jbudworth/LegoNXT_SpektrumSatRx/LegoNXT_Spektrum_wiring.png

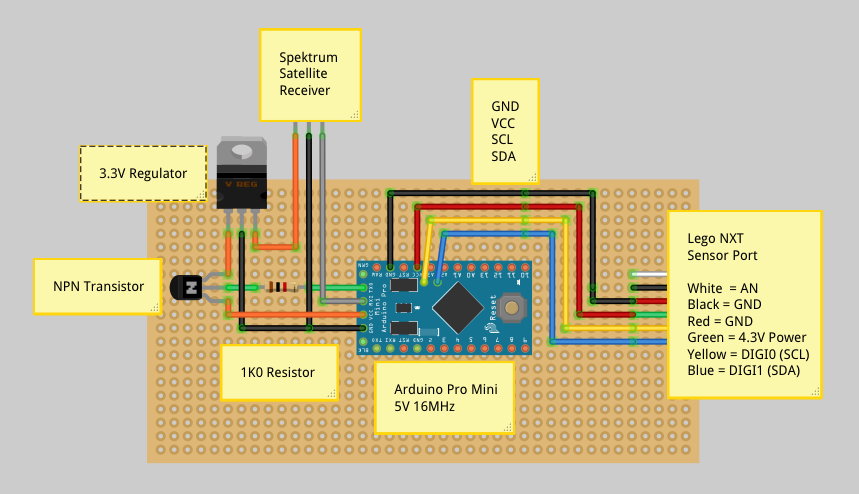
LegoNXT_Spektrum_wiring.png
