jbudworth/LegoNXT_SpektrumSatRx/(commit log)

2011-12-27 Added wiring diagram.
2012-01-03 Code should now work with Orange receivers. Changed default pins to ones that will work. Added LED to indicate Bind connection Removed unused code.
